GadgetReboot/Loop_Switcher/README.md

# Loop_Switcher
Guitar Effects Loop Switcher Matrix Board
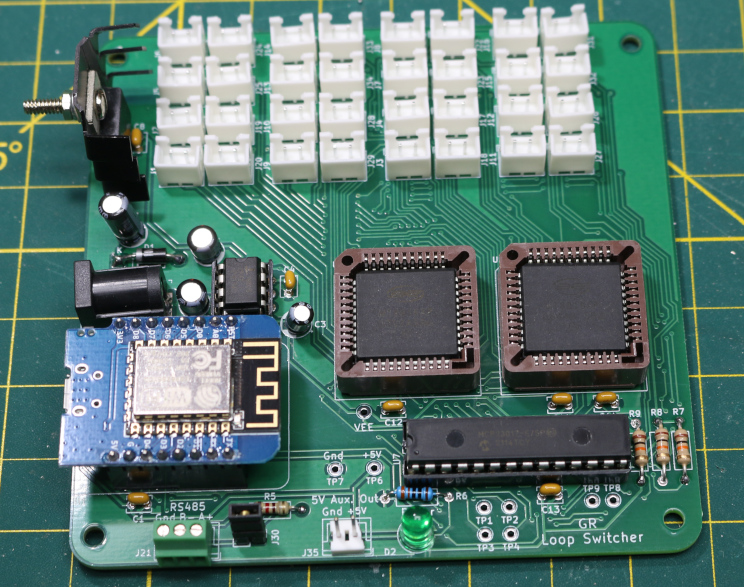
[picture p1: Assembled_PCB.jpg]
PCB
<br><br><BR><BR>
