GadgetReboot/Loop_Switcher/GR_Loop_Switcher_Sch.pdf

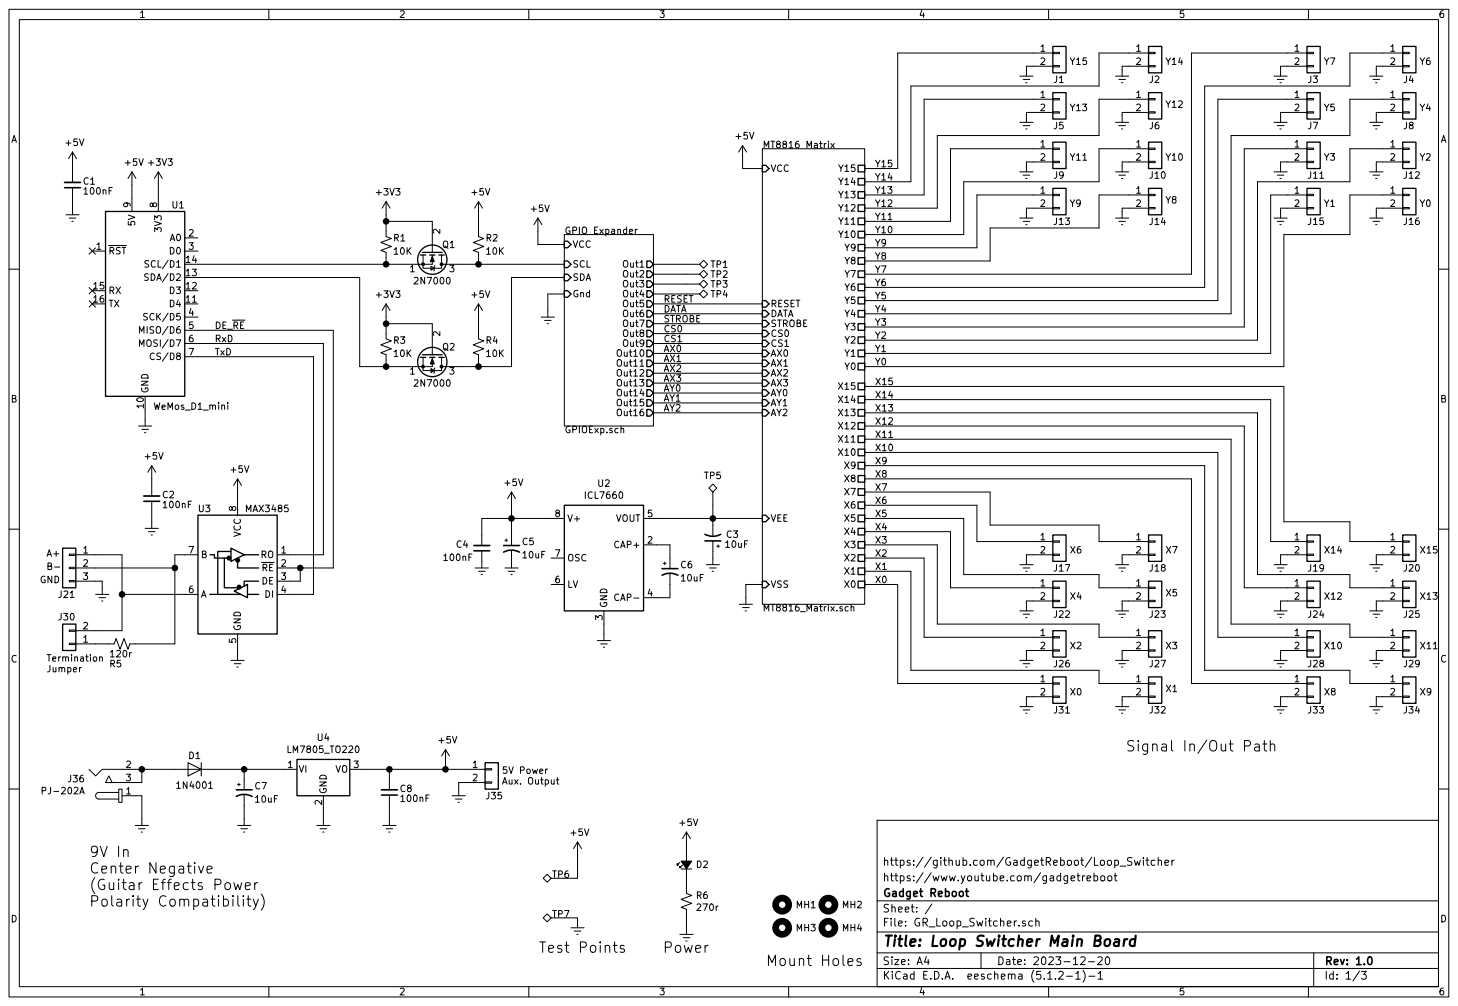
[picture p2: page 1]

9U1 WeMos_D1_mini RO 1 RE 2 DE 3 DI 4 GND

https://www.youtube.com/gadgetreboot
File: GR_Loop_Switcher.sch Sheet: / Gadget Reboot

Id: 1/3 Title: Loop Switcher Main Board

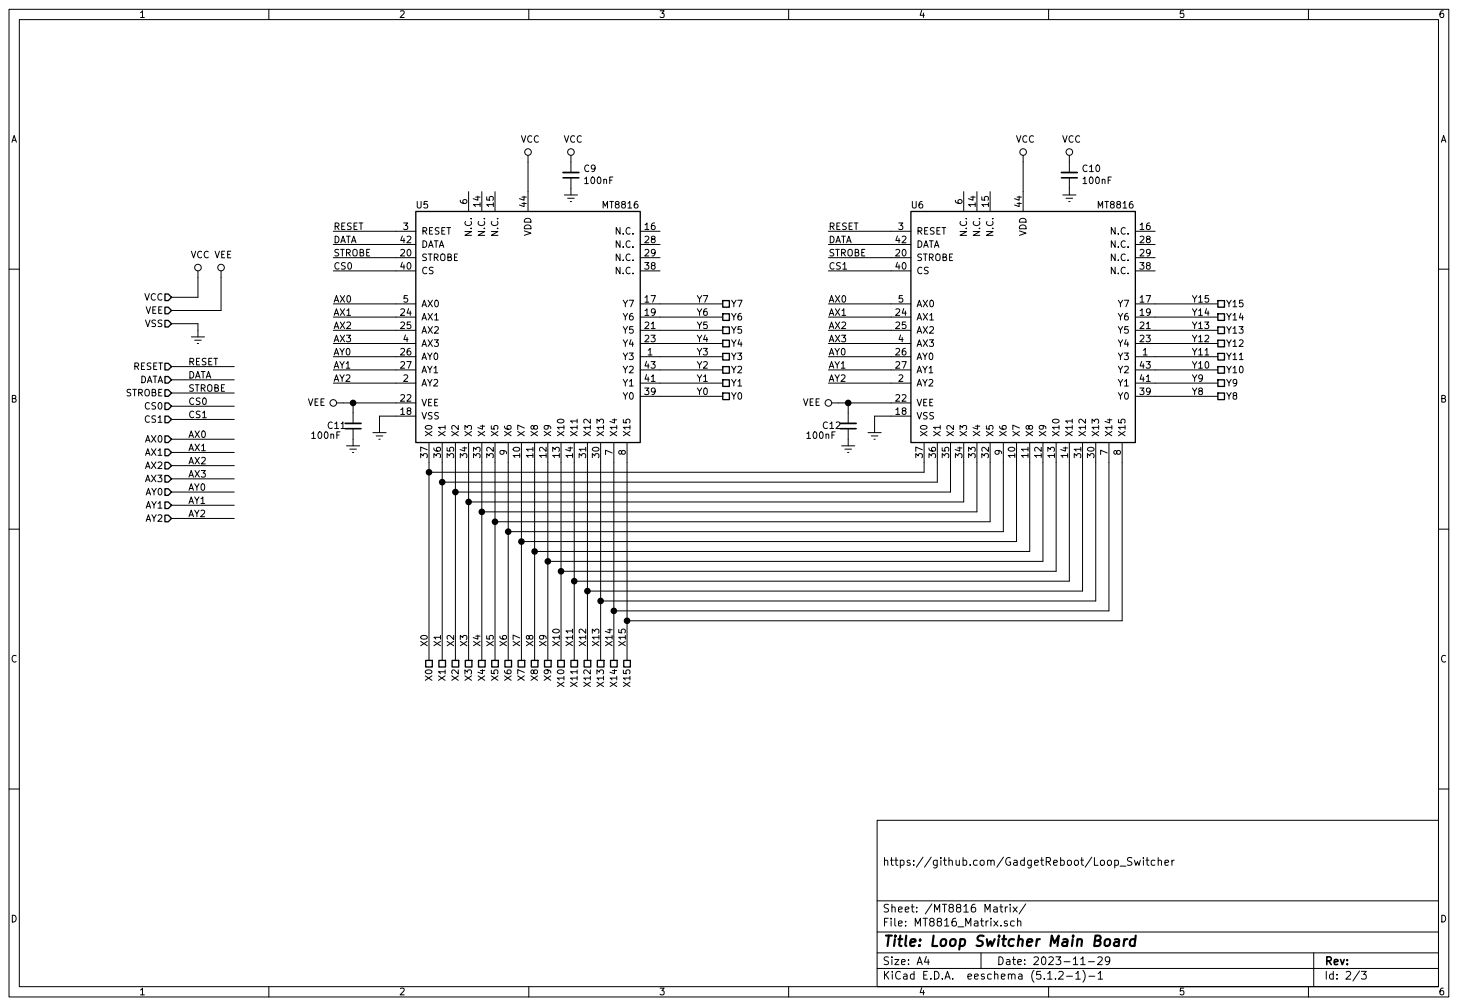
[picture p3: page 2]

9 U5 MT8816 Y3 1 X7 10 X8 11 X9 12 X10 13 N.C. 14 X11 14 N.C. 15 N.C. 16 Y7 17 VSS 18 Y6 19 AY2 2 STROBE 20 Y5 21 VEE 22 Y4 23 AX1 24 AX2 25 AY0 26 AY1 27 N.C. 28 N.C. 29 RESET 3 X13 30 X12 31 X5 32 X4 33 X3 34 X2 35 X1 36 X0 37 N.C. 38 Y0 39 AX3 4 CS 40 Y1 41 DATA 42 Y2 43 VDD 44 AX0 5 N.C. 6 X14

File: MT8816_Matrix.sch Sheet: /MT8816 Matrix/ https://github.com/GadgetReboot/Loop_Switcher

Id: 2/3 Title: Loop Switcher Main Board

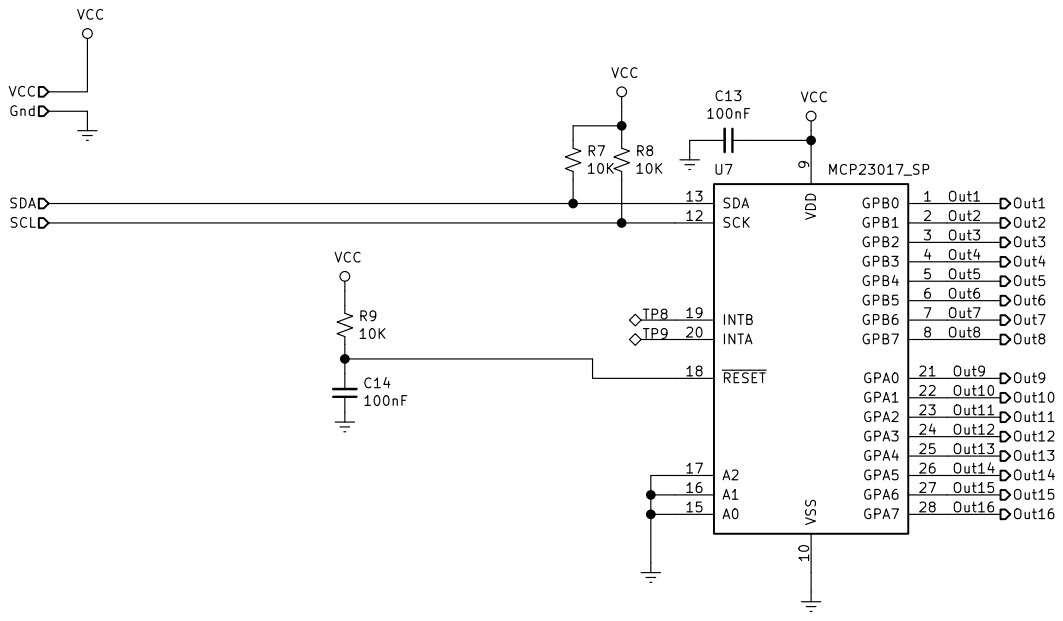
[picture p4: page 3]

https://github.com/GadgetReboot/Loop_Switcher

Sheet: /GPIO Expander/
File: GPIOExp.sch
Id: 3/3 Title: Loop Switcher Main Board
