GadgetReboot/Loop_Switcher/KiCad/GR_Loop_Switcher.kicad_pcb

## KiCad design KiCad/GR_Loop_Switcher.kicad_pcb (2023-12-21)

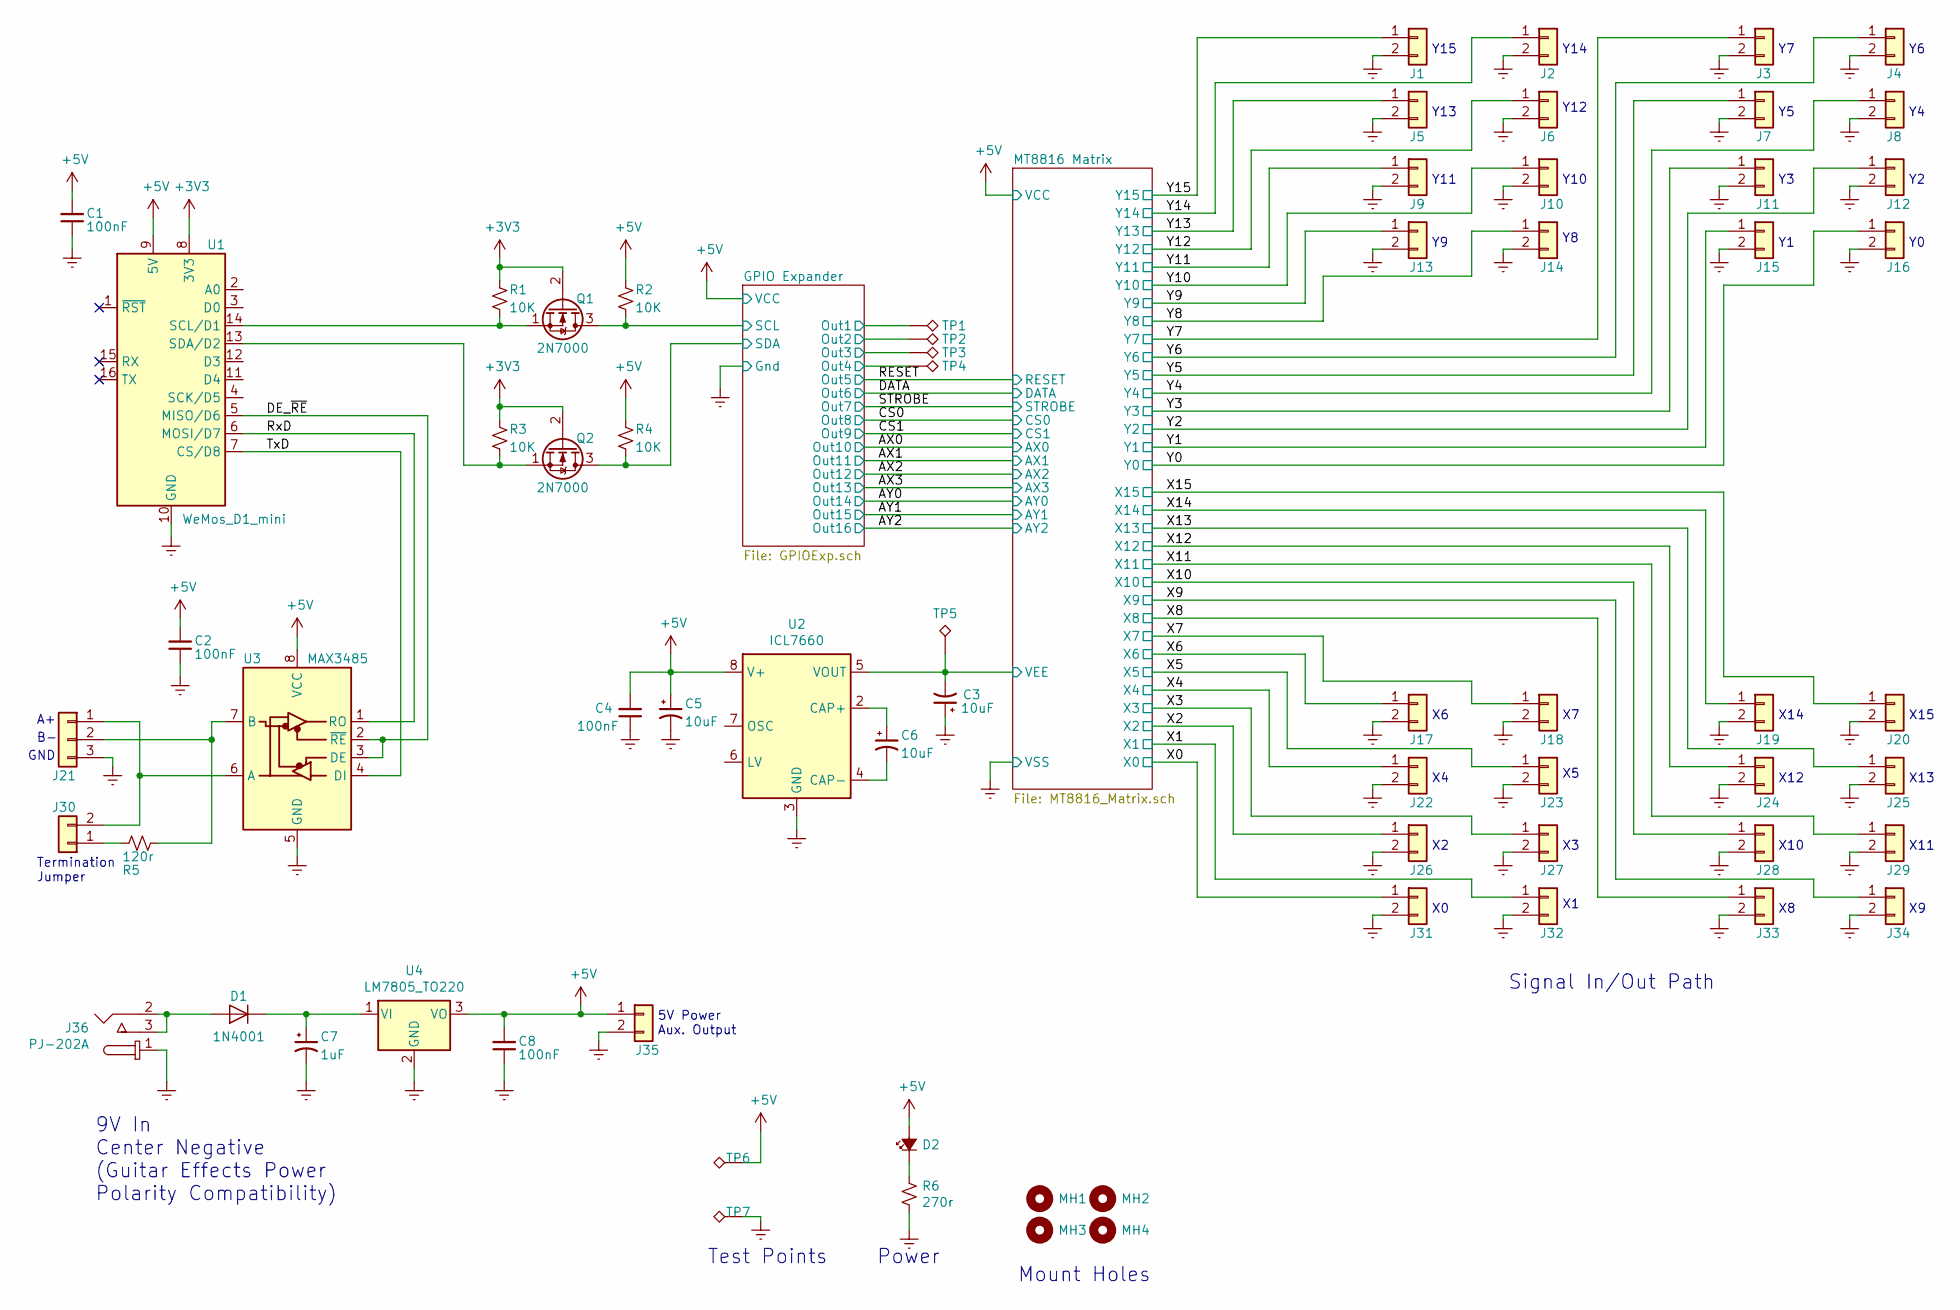
[picture p5: schematic GR_Loop_Switcher.sch, Loop Switcher Main Board]

Parts:
C1, C2, C4, C8: 100nF; C_Disc_D3.8mm_W2.6mm_P2.50mm
C3, C5, C6: 10uF; CP_Radial_D5.0mm_P2.50mm
C7: 1uF; CP_Radial_D5.0mm_P2.50mm
D1: 1N4001; D_DO-41_SOD81_P10.16mm_Horizontal
D2: LED_Small_ALT; LED_D5.0mm
J1, J2, J3, J4, J5, J6, J7, J8, J9, J10, J11, J12, J13, J14, J15, J16, J17, J18, J19, J20, J22, J23, J24, J25, J26, J27, J28, J29, J31, J32, J33, J34, J35: Conn_01x02; JST_XH_B2B-XH-A_1x02_P2.50mm_Vertical
J21: Conn_01x03; JST_XH_B3B-XH-A_1x03_P2.50mm_Vertical
J30: Conn_01x02; PinHeader_1x02_P2.54mm_Vertical
J36: PJ-202A; Barrel_Jack_5.5mmODx2.1mmID_PJ-202A; MPN PJ-202A; Digi-Key_PN CP-202A-ND
MH1, MH2, MH3, MH4: MountingHole; MountingHole_3.2mm_M3
Q1, Q2: 2N7000; TO-92_Inline
R1, R2, R3, R4: 10K; R_Axial_DIN0207_L6.3mm_D2.5mm_P10.16mm_Horizontal
R5: 120r; R_Axial_DIN0207_L6.3mm_D2.5mm_P10.16mm_Horizontal
R6: 270r; R_Axial_DIN0207_L6.3mm_D2.5mm_P10.16mm_Horizontal
TP1, TP2, TP3, TP4, TP5, TP6, TP7: TestPoint_Alt; TestPoint_THTPad_D2.0mm_Drill1.0mm
U1: WeMos_D1_mini; WEMOS_D1_mini_light
U2: ICL7660; DIP-8_W7.62mm_LongPads
U3: MAX3485; DIP-8_W7.62mm_LongPads
U4: LM7805_TO220; TO-220-3_Vertical

Connections:
+3V3: Q1.2 (G), Q2.2 (G), R1.1, R3.1, U1.8 (3V3)
+5V: C1.2, C2.2, C4.2, C5.1, C8.2, D2.2 (A), J35.1, R2.1, R4.1, TP6.1, U1.9 (5V), U2.8 (V+), U3.8 (VCC), U4.3 (VO); also elsewhere on the board
/DE_~RE: U1.5 (MISO/D6), U3.2 (~RE), U3.3 (DE)
/GPIO Expander/Out1: TP1.1; also elsewhere on the board
/GPIO Expander/Out2: TP2.1; also elsewhere on the board
/GPIO Expander/Out3: TP3.1; also elsewhere on the board
/GPIO Expander/Out4: TP4.1; also elsewhere on the board
/GPIO Expander/SCL: Q1.3 (D), R2.2; also elsewhere on the board
/GPIO Expander/SDA: Q2.3 (D), R4.2; also elsewhere on the board
/RxD: U1.6 (MOSI/D7), U3.1 (RO)
/TxD: U1.7 (CS/D8), U3.4 (DI)
/X0: J31.1; also elsewhere on the board
/X1: J32.1; also elsewhere on the board
/X2: J26.1; also elsewhere on the board
/X3: J27.1; also elsewhere on the board
/X4: J22.1; also elsewhere on the board
/X5: J23.1; also elsewhere on the board
/X6: J17.1; also elsewhere on the board
/X7: J18.1; also elsewhere on the board
/X8: J33.1; also elsewhere on the board
/X9: J34.1; also elsewhere on the board
/X10: J28.1; also elsewhere on the board
/X11: J29.1; also elsewhere on the board
/X12: J24.1; also elsewhere on the board
/X13: J25.1; also elsewhere on the board
/X14: J19.1; also elsewhere on the board
/X15: J20.1; also elsewhere on the board
/Y0: J16.1; also elsewhere on the board
/Y1: J15.1; also elsewhere on the board
/Y2: J12.1; also elsewhere on the board
/Y3: J11.1; also elsewhere on the board
/Y4: J8.1; also elsewhere on the board
/Y5: J7.1; also elsewhere on the board
/Y6: J4.1; also elsewhere on the board
/Y7: J3.1; also elsewhere on the board
/Y8: J14.1; also elsewhere on the board
/Y9: J13.1; also elsewhere on the board
/Y10: J10.1; also elsewhere on the board
/Y11: J9.1; also elsewhere on the board
/Y12: J6.1; also elsewhere on the board
/Y13: J5.1; also elsewhere on the board
/Y14: J2.1; also elsewhere on the board
/Y15: J1.1; also elsewhere on the board
GNDREF: C1.1, C2.1, C3.1, C4.1, C5.2, C7.2, C8.1, J1.2, J2.2, J3.2, J4.2, J5.2, J6.2, J7.2, J8.2, J9.2, J10.2, J11.2, J12.2, J13.2, J14.2, J15.2, J16.2, J17.2, J18.2, J19.2, J20.2, J21.3, J22.2, J23.2, J24.2, J25.2, J26.2, J27.2, J28.2, J29.2, J31.2, J32.2, J33.2, J34.2, J35.2, J36.1, R6.2, TP7.1, U1.10 (GND), U2.3 (GND), U3.5 (GND), U4.2 (GND); also elsewhere on the board
unnamed: C6.1, U2.2 (CAP+)
unnamed: C6.2, U2.4 (CAP-)
unnamed: C7.1, D1.1 (K), U4.1 (VI)
unnamed: D1.2 (A), J36.2, J36.3
unnamed: D2.1 (K), R6.1
unnamed: J21.1, J30.2, U3.6 (A)
unnamed: J21.2, R5.1, U3.7 (B)
unnamed: J30.1, R5.2
unnamed: Q1.1 (S), R1.2, U1.14 (SCL/D1)
unnamed: Q2.1 (S), R3.2, U1.13 (SDA/D2)
VEE: C3.2, TP5.1, U2.5 (VOUT); also elsewhere on the board

Notes on the sheet:
Mount Holes
Test Points
Signal In/Out Path
Power
9V In Center Negative (Guitar Effects Power Polarity Compatibility)
GND
Termination Jumper
Y15
Y14
Y13
Y12
Y11
Y10
X14
X15
X12
X13
X10
X11
5V Power Aux. Output

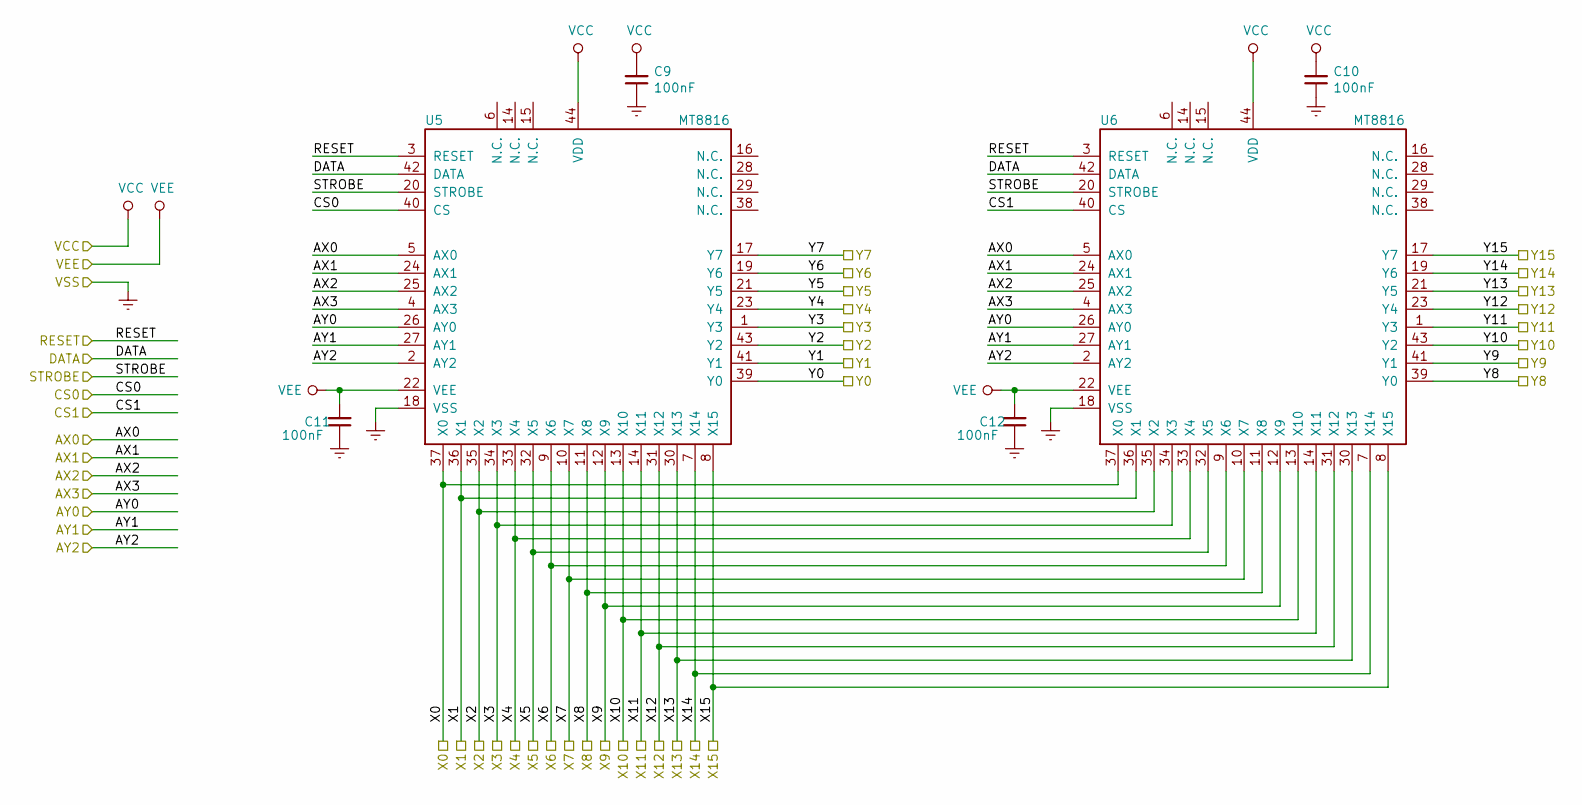
[picture p6: schematic MT8816_Matrix.sch, Loop Switcher Main Board]

Parts:
C9, C10, C11, C12: 100nF; C_Disc_D3.8mm_W2.6mm_P2.50mm
U5, U6: MT8816; PLCC-44_THT-Socket

Connections:
+5V: C9.2, C10.2, U5.44 (VDD), U6.44 (VDD); also elsewhere on the board
/AX0: U5.5 (AX0), U6.5 (AX0); also elsewhere on the board
/AX1: U5.24 (AX1), U6.24 (AX1); also elsewhere on the board
/AX2: U5.25 (AX2), U6.25 (AX2); also elsewhere on the board
/AX3: U5.4 (AX3), U6.4 (AX3); also elsewhere on the board
/AY0: U5.26 (AY0), U6.26 (AY0); also elsewhere on the board
/AY1: U5.27 (AY1), U6.27 (AY1); also elsewhere on the board
/AY2: U5.2 (AY2), U6.2 (AY2); also elsewhere on the board
/CS0: U5.40 (CS); also elsewhere on the board
/CS1: U6.40 (CS); also elsewhere on the board
/DATA: U5.42 (DATA), U6.42 (DATA); also elsewhere on the board
/RESET: U5.3 (RESET), U6.3 (RESET); also elsewhere on the board
/STROBE: U5.20 (STROBE), U6.20 (STROBE); also elsewhere on the board
/X0: U5.37 (X0), U6.37 (X0); also elsewhere on the board
/X1: U5.36 (X1), U6.36 (X1); also elsewhere on the board
/X2: U5.35 (X2), U6.35 (X2); also elsewhere on the board
/X3: U5.34 (X3), U6.34 (X3); also elsewhere on the board
/X4: U5.33 (X4), U6.33 (X4); also elsewhere on the board
/X5: U5.32 (X5), U6.32 (X5); also elsewhere on the board
/X6: U5.9 (X6), U6.9 (X6); also elsewhere on the board
/X7: U5.10 (X7), U6.10 (X7); also elsewhere on the board
/X8: U5.11 (X8), U6.11 (X8); also elsewhere on the board
/X9: U5.12 (X9), U6.12 (X9); also elsewhere on the board
/X10: U5.13 (X10), U6.13 (X10); also elsewhere on the board
/X11: U5.14 (N.C.), U6.14 (N.C.); also elsewhere on the board
/X12: U5.31 (X12), U6.31 (X12); also elsewhere on the board
/X13: U5.30 (X13), U6.30 (X13); also elsewhere on the board
/X14: U5.7 (X14), U6.7 (X14); also elsewhere on the board
/X15: U5.8 (X15), U6.8 (X15); also elsewhere on the board
/Y0: U5.39 (Y0); also elsewhere on the board
/Y1: U5.41 (Y1); also elsewhere on the board
/Y2: U5.43 (Y2); also elsewhere on the board
/Y3: U5.1 (Y3); also elsewhere on the board
/Y4: U5.23 (Y4); also elsewhere on the board
/Y5: U5.21 (Y5); also elsewhere on the board
/Y6: U5.19 (Y6); also elsewhere on the board
/Y7: U5.17 (Y7); also elsewhere on the board
/Y8: U6.39 (Y0); also elsewhere on the board
/Y9: U6.41 (Y1); also elsewhere on the board
/Y10: U6.43 (Y2); also elsewhere on the board
/Y11: U6.1 (Y3); also elsewhere on the board
/Y12: U6.23 (Y4); also elsewhere on the board
/Y13: U6.21 (Y5); also elsewhere on the board
/Y14: U6.19 (Y6); also elsewhere on the board
/Y15: U6.17 (Y7); also elsewhere on the board
GNDREF: C9.1, C10.1, C11.1, C12.1, U5.18 (VSS), U6.18 (VSS); also elsewhere on the board
VEE: C11.2, C12.2, U5.22 (VEE), U6.22 (VEE); also elsewhere on the board

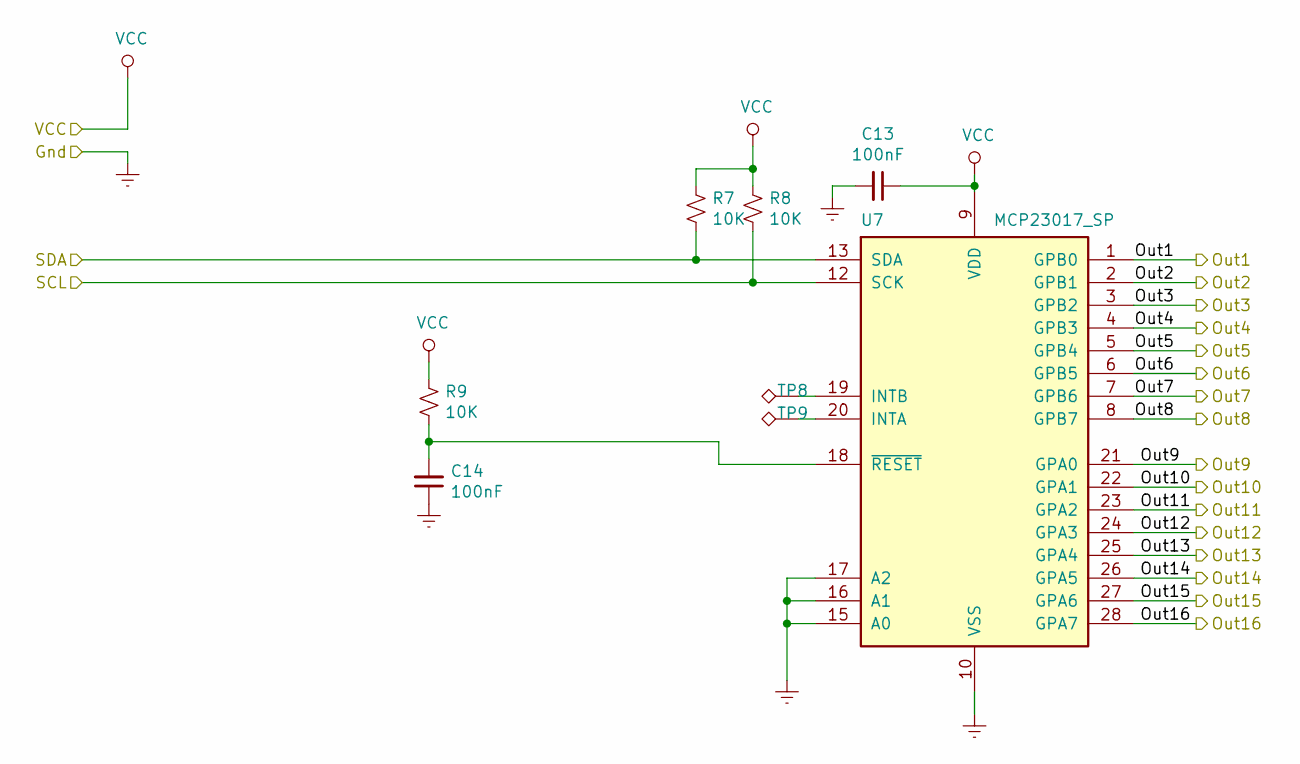
[picture p7: schematic GPIOExp.sch, Loop Switcher Main Board]

Parts:
C13, C14: 100nF; C_Disc_D3.8mm_W2.6mm_P2.50mm
R7, R8, R9: 10K; R_Axial_DIN0207_L6.3mm_D2.5mm_P10.16mm_Horizontal
TP8, TP9: TestPoint_Alt; TestPoint_THTPad_D2.0mm_Drill1.0mm
U7: MCP23017_SP; DIP-28_W7.62mm

Connections:
+5V: C13.1, R7.1, R8.1, R9.1, U7.9 (VDD); also elsewhere on the board
/AX0: U7.22 (GPA1); also elsewhere on the board
/AX1: U7.23 (GPA2); also elsewhere on the board
/AX2: U7.24 (GPA3); also elsewhere on the board
/AX3: U7.25 (GPA4); also elsewhere on the board
/AY0: U7.26 (GPA5); also elsewhere on the board
/AY1: U7.27 (GPA6); also elsewhere on the board
/AY2: U7.28 (GPA7); also elsewhere on the board
/CS0: U7.8 (GPB7); also elsewhere on the board
/CS1: U7.21 (GPA0); also elsewhere on the board
/DATA: U7.6 (GPB5); also elsewhere on the board
/GPIO Expander/Out1: U7.1 (GPB0); also elsewhere on the board
/GPIO Expander/Out2: U7.2 (GPB1); also elsewhere on the board
/GPIO Expander/Out3: U7.3 (GPB2); also elsewhere on the board
/GPIO Expander/Out4: U7.4 (GPB3); also elsewhere on the board
/GPIO Expander/SCL: R8.2, U7.12 (SCK); also elsewhere on the board
/GPIO Expander/SDA: R7.2, U7.13 (SDA); also elsewhere on the board
/RESET: U7.5 (GPB4); also elsewhere on the board
/STROBE: U7.7 (GPB6); also elsewhere on the board
GNDREF: C13.2, C14.1, U7.10 (VSS), U7.15 (A0), U7.16 (A1), U7.17 (A2); also elsewhere on the board
unnamed: C14.2, R9.2, U7.18 (~RESET~)
unnamed: TP8.1, U7.19 (INTB)
unnamed: TP9.1, U7.20 (INTA)

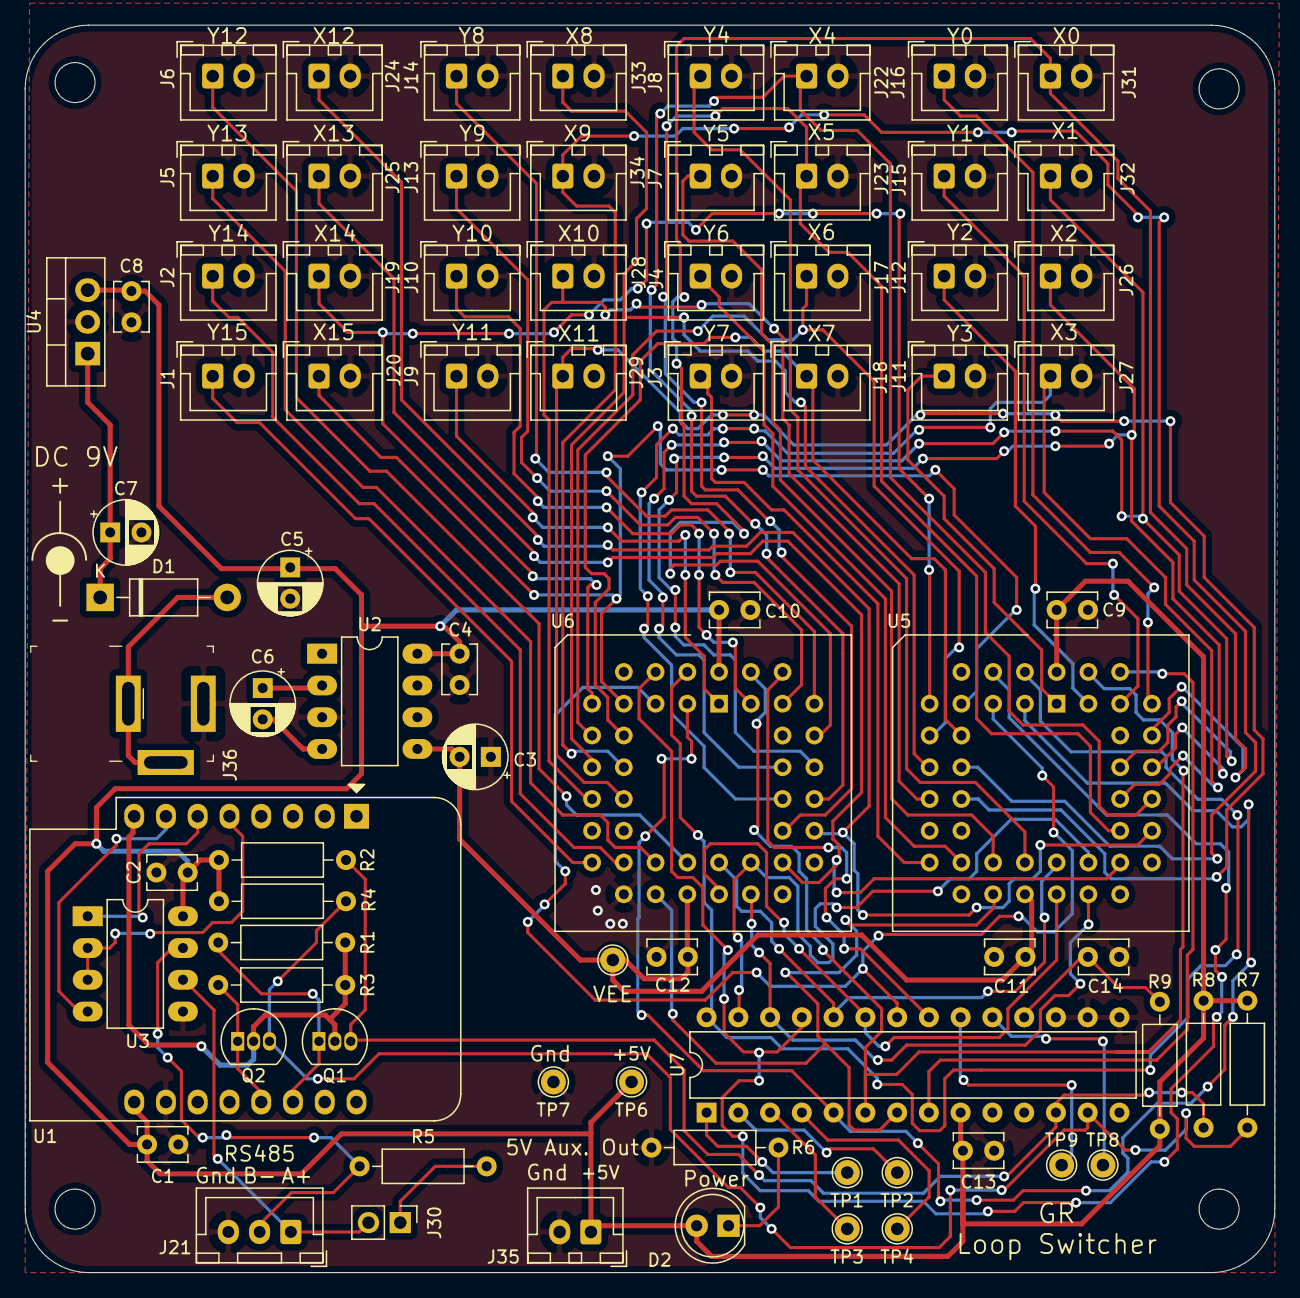
[picture p8: board GR_Loop_Switcher.kicad_pcb from above]

Board: 2 copper layers, 99.9 x 99.8 mm, 83 parts (0 on the bottom side), 70 nets.
