GadgetReboot/Loop_Switcher/(threads)

Thread 1 (2024-03-01):

The MT8816 datasheet seems a bit strange.

daniel-kedem6, 2024-03-01:
Hello, Thank you for sharing good information.
I'm asking a question because something strange happened while I was looking at the GR_Loop_Switcher_Sch.pdf file.

It's related to the MT8816AP, but the pin numbers are different. When I looked closely, it seemed to be socket-based, but something was still strange.
It seems like pins 3, 4, and 5 are pushed back one by one compared to the actual database. I took a picture with a tester and it was different from your schematic and data sheet.
However, it seems to work properly if I do it like your schematic, but it doesn't work if I do it like an actual data sheet. The manufacturer's datasheet is wrong, right?

Closed 2024-03-01.
